mb2372/ece3400-team1/docs/index.md

Meet our robot!

<iframe width="640" height="480" src="https://www.youtube.com/embed/a-czcSevky4" frameborder="0" allowfullscreen></iframe>

### Contributors
 - Manhal Bouarada          [mb2372](mailto:mb2372@cornell.edu)
 - Jason Russo              [jr826](mailto:jr826@cornell.edu)
 - Grant Headrick           [grh73](mailto:grh73@cornell.edu)
 - Beau Si                  [bs655](mailto:bs655@cornell.edu)
 
### Labs
 - [Lab 1](./labs/lab1.md)
 - [Lab 2](./labs/lab2.md)
 - [Lab 3](./labs/lab3.md)
 - [Lab 4](./labs/lab4.md)

### Milestones
 - [Milestone 1](./milestones/milestone1.md)
 - [Milestone 2](./milestones/milestone2.md)
 - [Milestone 3](./milestones/milestone3.md)
 - [Milestone 4](./milestones/milestone4.md) 

### Final Design
 - [Final Robot Design](./finalrobot/FinalDesign.md)
 
#### [Team Contract](./team_contract/team_contract.pdf)
#### [Ethics](./ethics/ethics.pdf)
