mb2372/ece3400-team1/docs/labs/images/lab1/6.jpg

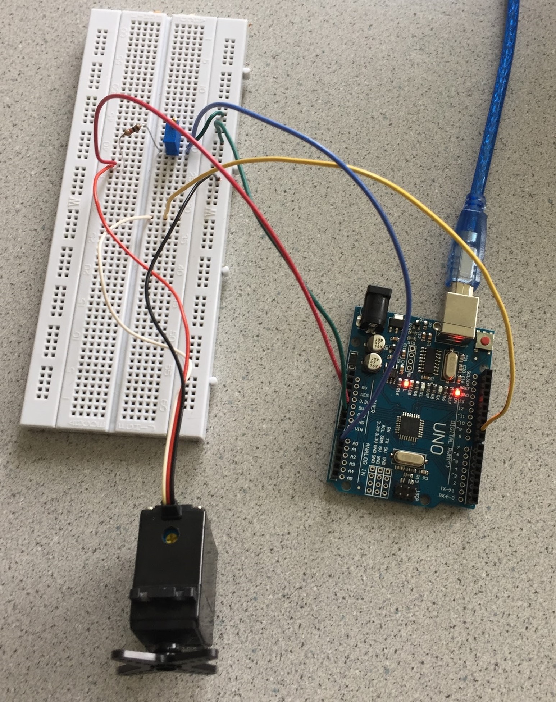
docs/labs/images/lab1/6.jpg
