mb2372/ece3400-team1/docs/milestones/images/milestone1images/diagram.PNG

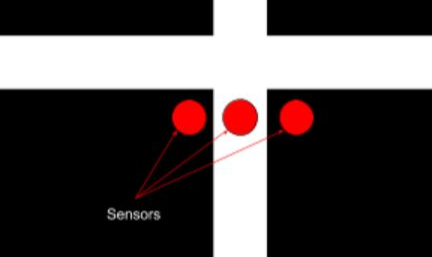
docs/milestones/images/milestone1images/diagram.PNG
