mb2372/ece3400-team1/docs/milestones/images/milestone1images/s.PNG

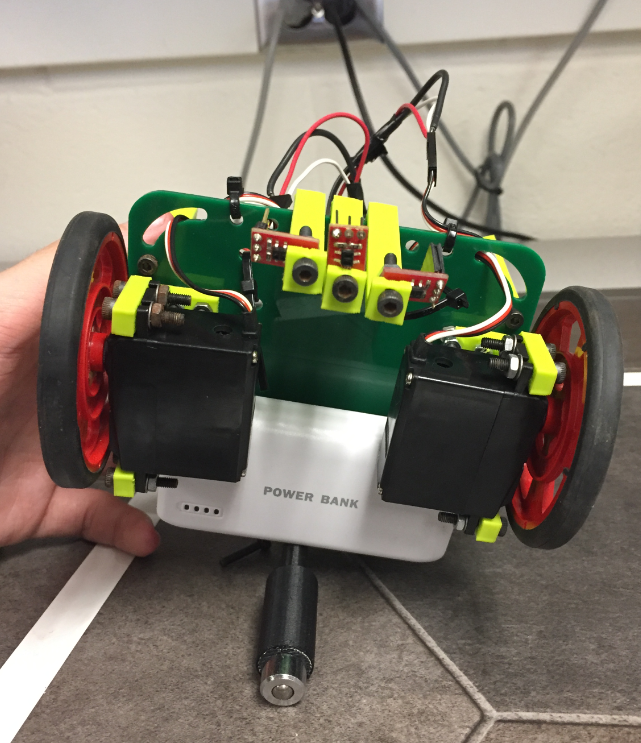
docs/milestones/images/milestone1images/s.PNG
