mb2372/ece3400-team1/docs/milestones/images/milestone1images/sensor_diagram.JPG

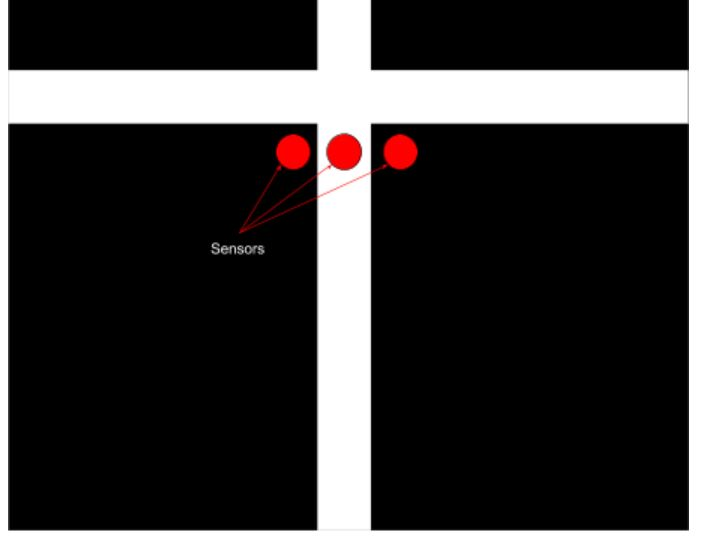
docs/milestones/images/milestone1images/sensor_diagram.JPG
